db-electronics/UMDv3-genesis-kicad/genesis-umd/schematics/genesis-umd_v3.1.pdf

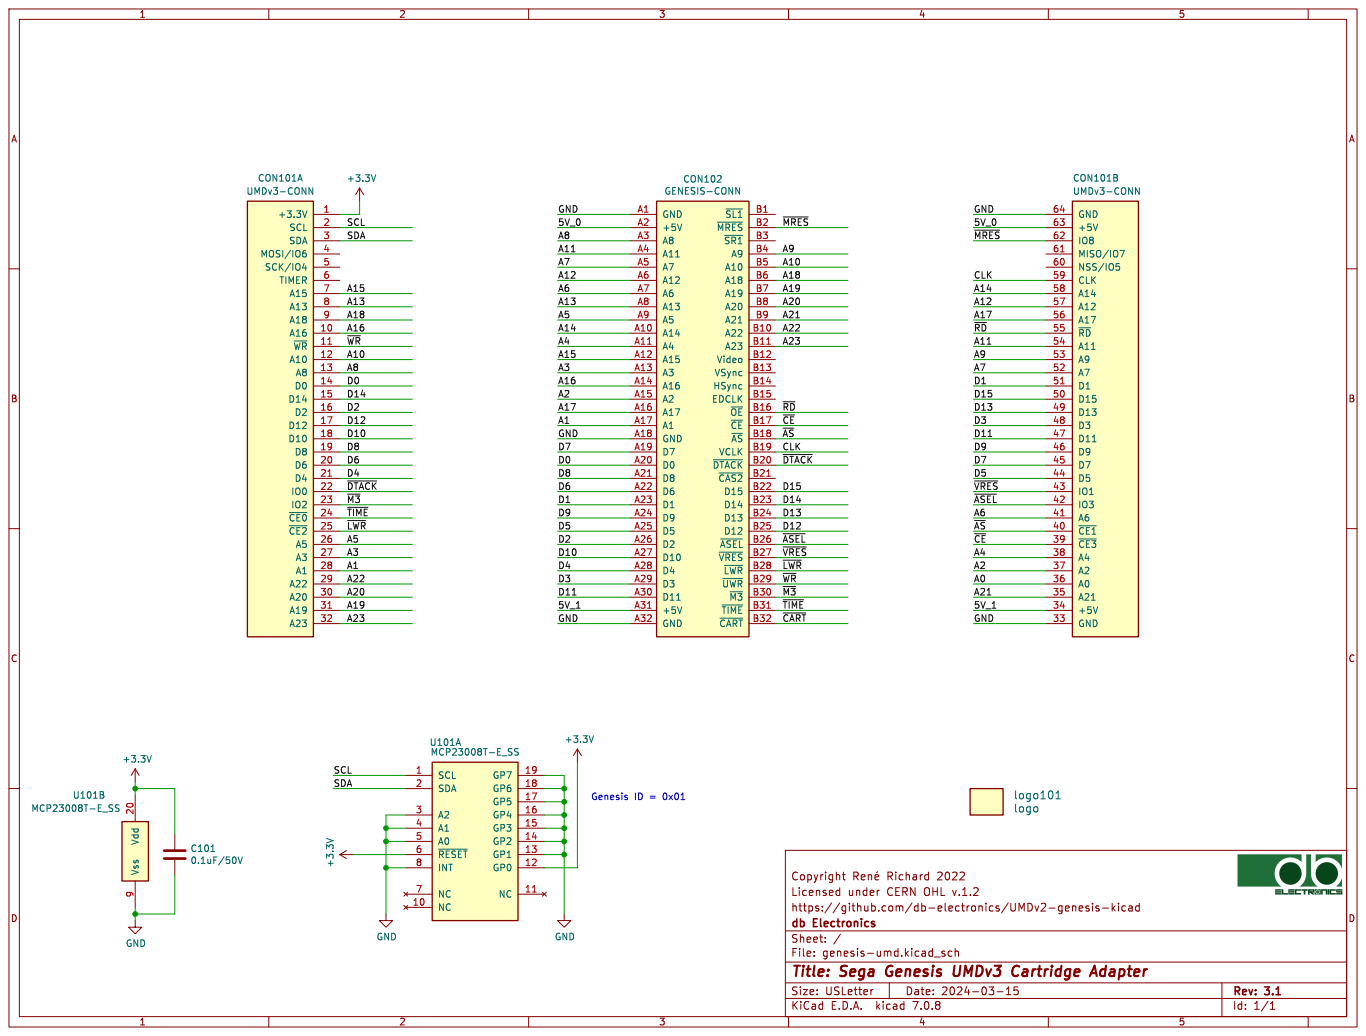
[picture p1: page 1]

https://github.com/db-electronics/UMDv2-genesis-kicad
