db-electronics/UMDv3-genesis-kicad/genesis-umd/schematics/genesis-umd_v3.0.pdf

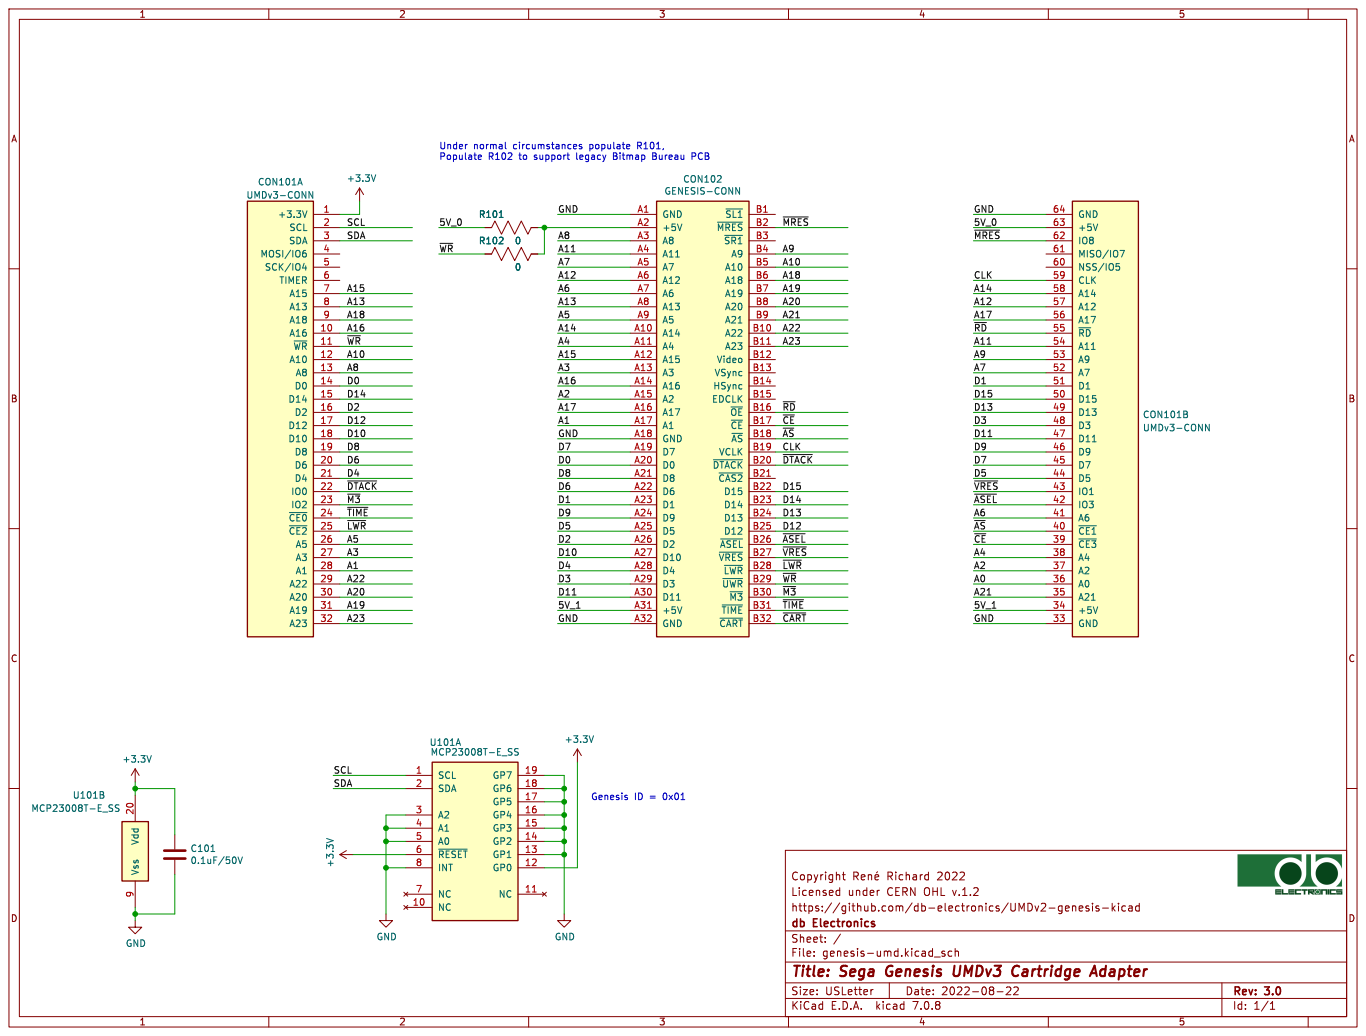
[picture p2: page 1]

https://github.com/db-electronics/UMDv2-genesis-kicad
