db-electronics/UMDv3-genesis-kicad/(commit log)

2022-08-22 initial files commit
    [genesis-umd.kicad_pcb, genesis-umd.kicad_sch]
2022-08-23 version 3.0 pcb
    [genesis-umd.kicad_pcb]
2022-08-23 better file structure
    [genesis-umd.kicad_pcb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]
2023-12-16 added missing gerbers and schematics
    [genesis-umd-B_Cu.gbl, genesis-umd-B_Mask.gbs, genesis-umd-B_Silkscreen.gbo, genesis-umd-Edge_Cuts.gm1, genesis-umd-F_Cu.gtl, genesis-umd-F_Mask.gts, genesis-umd-F_Silkscreen.gto, genesis-umd.drl]
2024-03-15 version 3.1 - added silkscreen text to show pcb orientation, removed nWR redirect support
    [genesis-umd-B_Cu.gbl, genesis-umd-B_Mask.gbs, genesis-umd-B_Silkscreen.gbo, genesis-umd-Edge_Cuts.gm1, genesis-umd-F_Cu.gtl, genesis-umd-F_Mask.gts, genesis-umd-F_Silkscreen.gto, genesis-umd.drl]
2024-03-15 added BOM
    [genesis-umd_v3.1.csv]
