db-electronics/UMDv3-genesis-kicad/(notices)

Notices in the files:
genesis-umd/genesis-umd.kicad_pcb:
Licensed Under CERN OHL v.1.2
genesis-umd/genesis-umd.kicad_sch:
Copyright René Richard 2022
